tonyy-shin/Smart-Sweat-Band-Project/libraries.md

# Arduino Library Dependencies

All libraries are installed via Arduino IDE Library Manager.

| Library | Author | Version | Purpose | Phase Added |
| :--- | :--- | :--- | :--- | :--- |
| MAX30205 | Protocentral | Latest | Clinical temperature sensor (I2C) | Phase 1 |
