tonyy-shin/Smart-Sweat-Band-Project/hardware/BOM.md

1x Microcontroller Board: ESP32-S3 DevKit
Estimated Cost: $7.49

1x Clinical Temperature Sensor: MAX30205 Breakout Board
Estimated Cost: $21.13

1x Prototyping Wires: 30 AWG Flexible Silicone Stranded Wire
Estimated Cost: $12.99

1x Diagnostic Tool: Micro Test Hook Clips
Estimated Cost: $7.69

1x Data/Sync Cable: USB-C Data Cable
Estimated Cost: $14.99

Estimated Total: $64.29 (without shipping fee)
