tonyy-shin/Smart-Sweat-Band-Project/dev_logs/SSB_devlog_2026-06-30.md

# SSB Dev Log — June 30, 2026

## Summary

Implemented and verified `main.cpp`, the firmware entry point for the Smart
Sweat-Band ESP32S3 device. This completes the Phase 1 firmware integration:
all sensor, storage, and transfer modules (built in milestones 1.0–1.6) are
now wired together into a single working state machine boot sequence. Also
found and fixed a pre-existing, unrelated build-blocking bug in
`platformio.ini`.

No hardware was available today, so all verification was limited to a clean
compile (`pio run`) — physical bench testing is queued for the next session
with the device in hand.

---

## What was implemented

### `firmware/ssb_firmware/src/main.cpp`

Previously an empty file (0 bytes). On inspection, the sensor, storage, and
transfer logic already existed in their own modules (`sensors.cpp`,
`storage.cpp`, `transfer.cpp`, `state_machine.cpp`) — `main.cpp` was the only
missing piece. Implemented as a thin entry point:

- `setup()`: starts Serial at 115200, sets `analogReadResolution(12)`
  (explicit 12-bit ADC documentation), calls `sensors_init()` and
  `state_machine_init()`.
- **Boot-time recovery guard**: if `storage_init() && storage_session_exists()`
  is true, the device jumps straight into `TRANSFER_READY` instead of
  `IDLE`. This prevents a fresh `RECORDING` session from truncating/
  overwriting an unconfirmed prior session still sitting on flash.
- `loop()`: pumps `state_machine_update()` then `led_update()`, with a
  `delay(10)` to keep button/serial polling responsive without busy-spinning.

### Design decisions confirmed during plan review

- **Serial protocol**: kept the existing ASCII scheme already implemented in
  `transfer.cpp` (`'R'` request → CSV stream → `END` sentinel → `'C'`
  confirm), rather than switching to a binary protocol.
- **CSV format**: kept the existing **5-column** row —
  `timestamp_ms, skin_temp_c, humidity_pct, chamber_temp_c, gsr_raw` —
  including the SHT45 chamber temperature column. This is a deliberate
  deviation from the original 4-column spec in `SSB_architecture.md`
  (**architecture doc still needs updating to reflect this** — see Open
  Items below).
- Added an extra verification step beyond the original plan: pulling power
  mid-`RECORDING` (not via Button A) to confirm the boot guard still detects
  a leftover session even when the file was never cleanly closed.

---

## Bug found & fixed: `platformio.ini`

`pio run` failed before compilation ever started — library install aborted
with `UnknownPackageError` on the MAX30205 dependency.

**Root cause**: `lib_deps` had a truncated, miscapitalized package name
(`protocentral/Protocentral MAX30205`) that didn't match the registry.

**Fix**:
```ini
lib_deps =
  adafruit/Adafruit SHT4x Library
  adafruit/Adafruit BusIO
  protocentral/ProtoCentral MAX30205 Body Temperature Sensor Library
```

This was a pre-existing bug unrelated to today's `main.cpp` work — it predates
this session and was simply never triggered until the first `pio run` was
attempted.

---

## Build verification

```
pio run
...
RAM:   6.0% (19,812 / 327,680 bytes)
Flash: 9.8% (327,533 / 3,342,336 bytes)
========================= [SUCCESS] Took 14.32 seconds =========================
```

Clean compile, zero warnings, all module headers/symbols resolved correctly
against `main.cpp`. Plenty of RAM/flash headroom remaining.

---

## Git

Two separate commits (kept apart since the platformio.ini fix is an
unrelated pre-existing bug, not part of the `main.cpp` feature):

1. `fix(firmware): correct ProtoCentral MAX30205 library name in platformio.ini`
2. `feat(firmware): add main.cpp entry point with state machine boot + recovery guard`

---

## Outstanding / next steps

**Requires hardware (queued for next session with the board):**
1. Flash + `pio device monitor` walkthrough of the full state machine:
   `IDLE` → `RECORDING` → `TRANSFER_READY`
2. GSR calibration trigger test (skin contact, 100-sample baseline)
3. Serial transfer test: send `R`, confirm CSV + `END` stream back, send `C`,
   confirm deletion + return to `IDLE`
4. Recovery guard test #1: power-cycle with an *unconfirmed* session in
   `TRANSFER_READY` → confirm reboot lands in `TRANSFER_READY`, not `IDLE`
5. Recovery guard test #2 (new): pull power **mid-`RECORDING`** → confirm
   the guard still catches the leftover (possibly truncated) session on
   reboot
6. Immediate priority once the above pass: physical stress test verifying
   the 20% GSR drop logic fires correctly under real sweat conditions

**Documentation debt:**
- Update `SSB_architecture.md` — the CSV row format section still says
  4 columns; actual implementation uses 5 (includes `chamber_temp_c`).
  `parser.py` (Phase 3) will need to be written against the 5-column format.

**Known non-blocking quirks (existing behavior, flagged not fixed):**
- `sensors_init()` hangs indefinitely if the SHT45 isn't physically present.
- `gsr_calibrate()` blocks during the `IDLE`→`RECORDING` transition until
  skin contact is detected; LED doesn't update during that wait.
- A session recovered via the mid-`RECORDING` power-pull guard may have a
  truncated final CSV row (data since the last 60s flush is lost) —
  `serial_receiver.py` will need to tolerate this when it's built.

---

# Phase 3 Backend — `parser.py` + test/CI foundation (same evening)

## Summary

Started the Python backend the same evening as the `main.cpp` firmware work above.
Implemented `ssb_backend/parser.py`, which converts the firmware's raw session CSV into
structured sample dicts, and stood up the backend's testing/CI foundation: a full `pytest`
suite (9 tests, all passing) plus a GitHub Actions workflow that is now the standing
verification method for backend changes.

Unlike the firmware work above, none of this needs the physical device — the parser is
pure CSV/text processing, so everything here was verified locally and in CI rather than
being queued for hardware bench time.

---

## What was implemented

### `ssb_backend/parser.py` (new, 129 lines)

Public entry point:

```python
def parse_session_csv(csv_data: str | bytes, gsr_baseline: int | None = None) -> ParseResult
```

Parses the firmware's 5-column session CSV
(`timestamp_ms, skin_temp_c, humidity_pct, chamber_temp_c, gsr_raw`) into a `list[dict]`
of samples. **Standard-library only** — `logging`, `re`, `dataclasses`; no external
dependencies.

- **Two-pass line classification.** Pass 1 walks every line and separates *expected
  non-data* lines (blank, `#`-prefixed comment, exact-match header, `END` sentinel) from
  *data-eligible* lines. Pass 2 parses every data-eligible line and accounts for each one.
  The point is that no line can silently vanish — it is either explicitly classified as
  expected non-data, or it is parsed and counted (as a sample or as a failure).
- **Anchored baseline regex.** The firmware's `# gsr_baseline=<int>` comment is matched
  with `^#\s*gsr_baseline\s*=\s*(\d+)`. Anchoring at `^#` prevents a stray
  `gsr_baseline=` elsewhere in a line from being misread. The optional `gsr_baseline`
  parameter takes precedence over the parsed value when supplied (caller override wins).
- **Two distinct failure modes**, reported separately rather than conflated:
  `truncated_final_row: bool` is the expected signature of a power-pull mid-`RECORDING`
  (the last row was mid-write — tolerable), while `malformed_row_count: int` counts any
  *other* row that fails to parse (real mid-session corruption). Downstream code should
  treat these differently, so collapsing them into one count would lose the distinction.

### Testing & CI foundation

- **`ssb_backend/tests/test_parser.py`** — 9 `pytest` functions, all passing:
  `test_wellformed_csv`, `test_truncated_final_row`, `test_malformed_middle_row`,
  `test_baseline_override`, `test_empty_string`, `test_bytes_input`,
  `test_crlf_line_endings`, `test_stray_end_sentinel`, `test_no_baseline_no_override`.
  Covers the happy path, both failure modes, override precedence, empty input, `bytes`
  vs `str` equivalence, CRLF endings, and a stray `END` sentinel.
- **`pyproject.toml`** (repo root) — `pythonpath = ["."]` and
  `testpaths = ["ssb_backend/tests"]` under `[tool.pytest.ini_options]`, resolving the
  `ssb_backend.parser` import from the test file without `sys.path` hacks. Paired with
  package markers `ssb_backend/__init__.py` and `ssb_backend/tests/__init__.py`.
- **`.github/workflows/ci.yml`** — GitHub Actions on `push`/`pull_request`, running the
  suite on Python 3.12 / `ubuntu-latest`. No lint or type-checking yet (deferred). CI is
  now the standing verification method for backend changes.
- **`.gitignore`** — added a `# Python` section (`__pycache__/`, `*.py[cod]`,
  `*.egg-info/`, `.pytest_cache/`) to the existing Arduino/PlatformIO rules. `.venv/` was
  already covered by an earlier entry.

---

## Process notes: bugs caught in pre-commit review

Several draft/review cycles caught bugs before they were committed:

- **Unanchored baseline regex** — an early pattern lacked the `^#` anchor and could have
  matched `gsr_baseline=` text anywhere in a line. Fixed to the anchored form above.
- **Silent-skip heuristic** — an early design skipped non-data-looking lines silently,
  which could have undercounted real data loss. Replaced with the explicit two-pass
  classification so every line is accounted for.
- **Conflated dropped-row counter** — an early `ParseResult` used a single dropped-row
  count that couldn't distinguish tolerable tail truncation from real corruption. Split
  into `truncated_final_row` + `malformed_row_count`.
- **`skin_temps_c` typo** — a hand-typed `_COLUMNS` field was briefly misspelled
  `skin_temps_c` instead of `skin_temp_c`, which would have broken the header exact-match
  check on every real session. Caught and corrected before commit.

---

## Build verification

```
pytest
========================= 9 passed =========================
```

All 9 tests pass locally; CI runs the same suite on Python 3.12 / ubuntu-latest on every
push and PR. No hardware needed.

---

## Git

Two commits, kept scoped separately per this project's convention of not mixing unrelated
concerns (both landed on `main`):

1. `fb43550` — `test(backend): add pytest + GitHub Actions CI`
   (test suite, `ci.yml`, `pyproject.toml`, package `__init__.py` markers, `.gitignore`
   Python section)
2. `740014f` — `feat(backend): add parser.py for CSV parsing`
   (`parser.py` only, 129 lines)

Committed in that order (`fb43550` first, then `740014f`), both timestamped ~16:50.

**Branch convention change going forward:** `parser.py` and its test/CI foundation landed
directly on `main`. From here on, new backend modules (`serial_receiver.py` and beyond)
will be developed on a dedicated `phase3/python-backend` branch rather than committed
straight to `main`.

---

## Outstanding / next steps (backend)

**Next module:**
- `serial_receiver.py` — serial port detection, transfer request (`R`), CSV reception,
  and confirmation send (`C`), per the existing spec in `SSB_architecture.md`. It will
  consume `parse_session_csv()` and must tolerate a `truncated_final_row` from a
  power-pulled session (see the firmware quirks above).

**Testing status:**
- No hardware-dependent testing is needed for backend work so far — parsing and unit
  tests run without the physical device (pure CSV/text processing). The firmware work
  above remains the outstanding hardware item.
