tonyy-shin/Smart-Sweat-Band-Project/dev_logs/SSB_devlog_2026-07-07.md

# SSB Dev Log — July 7, 2026

## Summary

Wired `ssb_backend/algorithm/electrolyte_intensity.py`'s `modifier` and `tier`
into `rehydration.py`, so the rehydration prescription now personalizes its
sodium figure by the GSR-derived relative modifier instead of applying the bare
`SWEAT_SODIUM_MG_PER_L` population constant. This changes sodium's
`calibration_state` from a flat constant to a per-quantity personalized state:
`provisional` when the electrolyte baseline is insufficient, `gsr_adjusted`
once it isn't. Also made a small design simplification in
`electrolyte_intensity.py`'s degenerate-input guard along the way.

As with the rest of Phase 3 backend work, none of this needs the physical
device — everything is exercised via `tmp_path` SQLite files.

---

## Part 1 — Plan review

The wiring went through plan mode before any code was typed. The plan was
reviewed and approved after two rounds of clarification:

- **`modifier=None` vs `1.0` in the degenerate guard.** Confirmed that
  `electrolyte_intensity.py`'s Step 1 guard should hand `rehydration.py` a
  neutral `1.0` rather than `None`, so the consumer never has to special-case a
  missing modifier before multiplying.
- **`Literal` import.** Confirmed `Literal` was already imported in
  `rehydration.py` (used by the existing `status` field), so the two new
  literal-typed fields needed no new import.

---

## Part 2 — Implementation

### `electrolyte_intensity.py` guard change

Step 1's degenerate-input guard (0 samples *or* `gsr_baseline <= 0`) now
returns `modifier=1.0` instead of `None`. This is a design simplification made
independently of the original wiring ask: a neutral `1.0` is what
`rehydration.py` multiplies against with no guarding, so the contract stays
uniform across every return path. It required a corresponding update to
`test_electrolyte_intensity.py` (the guard tests previously asserted
`modifier is None`).

### `rehydration.py` changes

- **Two new `RehydrationResult` fields:** `electrolyte_tier`
  (`Literal["insufficient_data", "low", "typical", "high"]`) and
  `calibration_state` (`dict[str, str]`, tracking `volume` and `sodium`
  independently).
- **`compute_volume_and_sodium` signature:** added a `modifier` parameter; the
  sodium line is now
  `(sweat_volume_ml / 1000.0) * SWEAT_SODIUM_MG_PER_L * modifier`.
- **`compute_rehydration_prescription` signature:** added a `db_path` parameter
  (default `history.DEFAULT_DB_PATH`), threaded through to the electrolyte call
  so tests can isolate history to a `tmp_path` DB.
- **Single `compute_gsr_electrolyte_adjustment` call site:** invoked once after
  the sample guards; `modifier = elec.modifier`, and
  `sodium_state = "provisional" if elec.insufficient_baseline else "gsr_adjusted"`.
  Both the zero-fluid early return and the normal return carry `electrolyte_tier`
  and the `calibration_state` dict.

### Bugs found and fixed during manual implementation

Both were self-caught while typing the implementation, before running the
suite:

1. **Missing fields on the success-path return.** The final
   `return RehydrationResult(...)` (the non-zero-fluid path) was initially
   written without `electrolyte_tier` or `calibration_state`. Since both are
   required dataclass fields, this would have raised `TypeError` on *every*
   real prescription — only the guard/zero-fluid returns would have worked.
2. **`insufficent_data` typo.** A misspelling (missing the second `i`) appeared
   in two places — the `Literal` type annotation on `electrolyte_tier` and the
   early-return string value. Left in, it would have silently disagreed with
   `electrolyte_intensity.py`'s correctly-spelled `"insufficient_data"`,
   breaking equality against the tier the electrolyte module actually emits.

---

## Part 3 — Tests

Changes to `ssb_backend/tests/test_rehydration.py`:

- **4 existing full-equality tests** updated to include the two new fields
  (`test_empty_sample`, `test_single_samples`,
  `test_zero_duration_returns_insufficient_data`,
  `test_zero_fluid_ok_empty_schedule`).
- **10 existing tests** threaded with `tmp_path` / `db_path` so the electrolyte
  call reads an isolated SQLite file instead of the real `ssb_history.db`.
- **1 new test** — `test_sodium_scaled_by_gsr_modifier` — seeds 3 history
  sessions (`gsr_drop_intensity=0.25`) so a current intensity of `0.5` yields a
  raw ratio of `2.0`, hitting `GSR_MODIFIER_MAX_CLAMP`. Asserts
  `calibration_state["sodium"] == "gsr_adjusted"`, `electrolyte_tier == "high"`,
  and that `total_sodium_mg` is exactly doubled.

**Build verification:**
`python -m pytest ssb_backend/tests/test_rehydration.py ssb_backend/tests/test_electrolyte_intensity.py -q`
→ **26 passed.**

---

## Git

Four commits, in dependency order, committed, pushed, and merged into `main`
(PR #11):

1. `fix(backend): default electrolyte modifier to 1.0 in guard`
2. `test(backend): update electrolyte_intensity tests for modifier=1.0`
3. `feat(backend): wire electrolyte_intensity modifier into rehydration`
4. `test(backend): update rehydration tests for electrolyte wiring and DB isolation`

---

## Outstanding / next steps

- **`scoring.py`** is next in dependency order — the composite Recovery
  Readiness Score, and critically the producer of both `thermal_slope` and
  `gsr_drop_intensity`, the two history keys `thermal.py` and
  `electrolyte_intensity.py` currently read via `# CONTRACT:` comments from an
  empty well.
- **Firmware hardware bench verification** and the **GSR 20%-drop real-sweat
  stress test** — still outstanding and hardware-blocked.
- **React/Recharts dashboard** — not started.
- **Vapor chamber ΔRH → mL/min characterization** — partner-led, still gates
  the volume half of `rehydration.py`.

---

# SSB Dev Log — July 7, 2026 (Session 2)

## Summary

Designed and implemented `ssb_backend/algorithm/scoring.py` — the composite
Recovery Readiness Score, and the producer of the `thermal_slope` and
`gsr_drop_intensity` history keys that `thermal.py` and
`electrolyte_intensity.py` have so far read via `# CONTRACT:` comments from
an empty well. That gap, identified in the July 5 audit, is now closed:
full regression proves both readers get non-empty baselines from scoring's
history writes. Also wrote its `pytest` suite (`test_scoring.py`, 11 tests).
Followed the same spec-first process as `electrolyte_intensity.py`: full
design spec reviewed through two critique rounds before any code was typed.

---

## Part 1 — Design spec

Two critique rounds against the spec resolved:

- **`sessions_used` naming collision.** Renamed scoring's field to
  `prior_session_count` — `ThermalResult.sessions_used` and
  `GsrElectrolyteResult.sessions_used` count *filtered valid* entries,
  whereas scoring's field is a raw row count; sharing the name would have
  invited confusion.
- **Explicit per-helper neutral-fallback conditions.**
  `_rehydration_subscore` falls back only when `total_fluid_ml is None`,
  never on a genuine `0.0`; `_thermal_subscore` falls back when *either*
  `current_slope` or `baseline_slope` is `None`; `_sri_subscore` falls back
  when `mean_sri is None`.
- **Field names verified against source.** Every input field was confirmed
  directly against `rehydration.py`/`sweat_rate.py` rather than assumed.
- **Double-compute TODO.** `compute_gsr_electrolyte_adjustment` runs twice
  per pipeline (once inside `rehydration.py`, once for scoring's history
  write) — flagged as an accepted tradeoff for `main.py` to revisit.

### Placeholder constants (with derivations)

- `REHYDRATION_FULL_DEFICIT_ML = 1500.0` — ~5 full 300 mL intake windows,
  a 90-min heavy-session reference deficit.
- `THERMAL_SCORE_GAIN = 5000.0` — calibrated so a slope gap at
  `thermal.py`'s `THERMAL_ALERT_MARGIN_C_PER_S` drops the sub-score 10
  points below neutral, keeping directional agreement with thermal's own
  alert logic.
- `SRI_FULL_STRESS = 0.1` %RH/s — set above the ~0.06–0.08 venting rates
  from the July 4 bench capture, so passive dry-bench readings don't
  misread as full sweat stress.

---

## Part 2 — Side-refactor attempted and reverted

A refactor was tried mid-implementation: adding
`current_intensity: float | None` to `RehydrationResult` so scoring could
read the GSR intensity off it directly instead of taking a fourth
`GsrElectrolyteResult` parameter. It was fully implemented (field + 3
construction sites + 5 `test_rehydration.py` edits) — then a correctness
review of the resulting scoring wiring caught a real bug:
`RehydrationResult.current_intensity` is `None` whenever rehydration's own
<2-sample guard fires, but `electrolyte_intensity.py` needs only 1 sample
to compute a real value. Sourcing scoring's history write from
`RehydrationResult` would silently write `None` in exactly the 1-sample
case where a real value existed — thinning the very baseline
`electrolyte_intensity.py` depends on. Reverted in full; `scoring.py` takes
`gsr_electrolyte_result: GsrElectrolyteResult` as its own fourth parameter
and reads `gsr_drop_intensity = gsr_electrolyte_result.current_intensity`
directly, per the approved spec's §6 recommendation.

---

## Part 3 — Implementation & correctness review

Two review rounds against the approved spec (8 explicit checks: CONTRACT
key correctness, field-source mapping, per-helper fallback conditions,
weighted combination, `prior_session_count` semantics, stabilizing flag,
constant values, score non-nullability). First round found:

1. **Crash bug** — `gsr_drop_intensity` initially sourced from the wrong
   object, raising `AttributeError` on every call (briefly papered over by
   the Part 2 side-refactor rather than fixed at the source).
2. **`stabalizing`/`stabilizing` misspelling** in 3 locations.
3. **Unapplied constant** — `REHYDRATION_FULL_DEFICIT_ML` briefly regressed
   to `1800.0` instead of the derived `1500.0`.
4. **Unbounded sub-score helpers** — `_thermal_subscore`/`_sri_subscore`
   not individually clamped to `[0, 100]`, and `_sri_subscore` used an
   incorrect absolute-cap normalization instead of the proper
   `mean_sri / SRI_FULL_STRESS` scale.

The second round confirmed all fixes landed, including that the crash-bug
fix reads from the restored `gsr_electrolyte_result` parameter (not
`rehydration_result`) after the Part 2 revert.

---

## Part 4 — Tests

`ssb_backend/tests/test_scoring.py` covers the 11 approved cases from the
spec's test plan: weighted-sum correctness, emit-never-withhold under full
insufficiency, CONTRACT key writes, the end-to-end round-trip proving
`thermal.py` and `electrolyte_intensity.py` read non-empty baselines after
3 scoring calls, `None`-thermal-slope handling, the stabilizing-flag
boundary at `SCORE_CALIBRATED_SESSIONS = 5`, directional sanity checks,
clamping at extremes, and `db_path`/timestamp isolation.

**Build verification:**
`test_scoring.py` → **11 passed.** Full regression
(`test_thermal.py` + `test_electrolyte_intensity.py` + `test_scoring.py`)
→ **27 passed** — the CONTRACT keys are not just written correctly but
actually consumable by both readers.

---

## Git

Two commits ready per convention (feature, then test) — **not yet
committed**:

1. `feat(backend): add scoring.py for Recovery Readiness Score`
2. `test(backend): add test_scoring.py for scoring.py`

---

## Outstanding / next steps

- **`api.py`** is next in dependency order (per `SSB_architecture.md`'s
  file structure), followed by **`main.py`** — which should also revisit
  the double-compute TODO from Part 1.
- **Firmware offset fix (`de77b70`)** — still pending cherry-pick onto
  `main` from `fix/hardware-testing`.
- **Firmware hardware bench verification** and the **GSR 20%-drop
  real-sweat stress test** — unchanged, hardware-blocked.
- **React/Recharts dashboard** — not started.
- **Vapor chamber ΔRH → mL/min characterization** — partner-led, still
  gates the volume half of `rehydration.py`.

---

# SSB Dev Log — July 7, 2026 (Session 3)

## Summary

Designed and implemented `ssb_backend/api.py` — the FastAPI surface
exposing `GET /results`, and the full-pipeline orchestrator
(`run_pipeline`) wiring `rehydration.py` → `thermal.py` →
`sweat_rate.py` → `electrolyte_intensity.py` → `scoring.py` →
`history.py`. Also implemented `build_recovery_plan`, a pure
plain-language recovery-plan builder, and wrote its full `pytest` suite
(`test_api.py`, 14 tests). Added `fastapi`, `uvicorn`, and `httpx` to
`requirements.txt`. Followed the same spec-first process as
`electrolyte_intensity.py` and `scoring.py`: full design spec reviewed
through two critique rounds before any code was typed.

---

## Part 1 — Design spec

Two critique rounds against the spec resolved:

- **Single-history-write invariant.** `scoring.py` already writes the
  session to history; `api.py` must *not* call `save_session` again.
  `run_pipeline` therefore performs no history write of its own.
- **Double-compute deferral accepted.**
  `compute_gsr_electrolyte_adjustment` runs twice per pipeline — once
  inside `rehydration.py`, once for scoring's 4th parameter. This is
  the same accepted tradeoff flagged in Session 2, deliberately
  deferred to `main.py` and not resolved here.
- **Emit-and-label fix in the thermal clause.** `build_recovery_plan`'s
  thermal clause now appends "(baseline still stabilizing)" when
  `insufficient_baseline` is `True`, emitting the message rather than
  withholding it.
- **404 vs `has_session: false`.** Explicit tradeoff decision on what
  `GET /results` returns before any pipeline run: chose **404**.

---

## Part 2 — Implementation

`ssb_backend/api.py` contains:

- **`GET /results`** — the FastAPI endpoint serving the latest pipeline
  results, returning 404 when no session has been processed yet.
- **`run_pipeline`** — the full-pipeline orchestrator, calling
  `rehydration.py` → `thermal.py` → `sweat_rate.py` →
  `electrolyte_intensity.py` → `scoring.py` → `history.py` in
  dependency order (history writes happen inside `scoring.py`, per the
  single-write invariant above).
- **`build_recovery_plan`** — a pure function translating pipeline
  results into a plain-language recovery plan.

`requirements.txt` gained `fastapi`, `uvicorn`, and `httpx`.

---

## Part 3 — Tests

`ssb_backend/tests/test_api.py` covers 14 cases, following the
`tmp_path` SQLite isolation convention used across the backend suites.
Notable: the **strengthened double-compute consistency check** —
asserting that the two `compute_gsr_electrolyte_adjustment` runs agree
not just on tier match but on *exact numeric equality* of
`total_sodium_mg`.

---

## Git

Three commits, in dependency order (feature → test → build, per
convention), committed, pushed, and merged into `main` (PR #13):

1. `feat(backend): add api.py for FastAPI results endpoint and pipeline orchestration`
2. `test(backend): add test_api.py for api.py`
3. `build: add fastapi, uvicorn, and httpx to requirements.txt for api.py`

---

## Outstanding / next steps

- **`main.py`** is next in dependency order — wires the serial listener
  to `run_pipeline`, and should revisit the double-compute deferral
  from Part 1.
- **Firmware offset fix (`de77b70`)** — still pending cherry-pick onto
  `main` from `fix/hardware-testing`.
- **Firmware hardware bench verification** and the **GSR 20%-drop
  real-sweat stress test** — unchanged, hardware-blocked.
- **React/Recharts dashboard** — not started.
- **Vapor chamber ΔRH → mL/min characterization** — partner-led, still
  gates the volume half of `rehydration.py`.
