tonyy-shin/Smart-Sweat-Band-Project/firmware/hardware_validation/phase1.0_baseline_thermometry/i2c_scanner/i2c_scanner.ino

#include <Wire.h>

void setup() {
  Serial.begin(115200);
  Wire.begin(D4, D5);
  Serial.println("Scanning I2C bus...");

  for (byte address = 1; address < 127; address++) {
    Wire.beginTransmission(address);
    byte error = Wire.endTransmission();

    if (error == 0) {
      Serial.print("Device found at address 0x");
      if (address < 16) Serial.print("0");
      Serial.println(address, HEX);
    }
  }
  Serial.println("Scan complete.");
}

void loop() {}
