tonyy-shin/Smart-Sweat-Band-Project/(commit log)

2026-03-18 Create BOM.md
    Added hardware bill of materials.
2026-04-12 feat: scaffold project structure for Phase 1
    - Add firmware/phase1_thermometry/ for Arduino sketch files
    - Add hardware/photos/ for build documentation images
    - Add docs/wiring/ for schematics and wiring diagrams
    - Add libraries.md to track Arduino library dependencies
2026-04-16 feat: add I2C scanner sketch and Phase 1 hardware photo
2026-04-16 feat: add phase 1 temperature reading sketch which includes calibration
2026-05-22 Add standalone SHT45 firmware and unified dual-sensor code
    Added a dedicated script to run and test the SHT45 humidity sensor independently. Also added a combined script to run both the SHT45 and the custom MAX30205 clone simultaneously on the shared I2C bus.
2026-05-22 Add dual-sensor breadboard wiring photo to hardware folder
2026-05-26 feat:sensor fusion with GSR calibration
2026-05-26 docs: sensor fusion setup
2026-06-29 fix: transition from windows to linux
    [i2c_scanner.ino, phase.1.5_sensor_fusion.ino, phase1.1_temp_read.ino, phase1.2_humidity_read.ino, phase1.3_temp_humidity_read.ino, phase1.4_gsr_read.ino]
2026-06-29 feat: Add ssb_firmware scaffold and sensors module
2026-06-29 fix: added storage delete method
    [storage.cpp, storage.h]
2026-06-29 feat: Add state machine module (4-state FSM, buttons, LED, 1Hz sampling)
2026-06-30 feat(firmware): implement USB Serial transfer handshake module (transfer.h/.cpp) and wire it into the state machine.
2026-06-30 fix: csv output spacing error
    [storage.cpp]
2026-06-30 refactor(firmware): added calibrated GSR to output
2026-07-01 feat(backend): add serial_receiver.py for USB device detection and transfer
2026-07-06 fix(backend): tolerate space-flexible gsr_baseline prefix in _looks_like_ssb
    [serial_receiver.py]
2026-07-07 feat(backend): wire electrolyte_intensity modifier into rehydration
2026-07-07 test(backend): update rehydration tests for electrolyte wiring and DB isolation
2026-07-08 feat(backend): wire _run_algorithm_pipeline to call run_pipeline
2026-07-08 fix(backend): pass computed elec into rehydration to eliminate double-compute
    [api.py]
2026-07-08 feat(backend): add GET /results/samples endpoint for raw sample time series
2026-07-08 test(backend): add tests for GET /results/samples endpoint
2026-07-08 feat(frontend): wire SessionHistoryPanel to /history with per-metric trend charts
2026-10-02 fix(firmware): clear stale button presses and serial input across state transitions
    [state_machine.cpp, transfer.cpp]
2026-10-14 Docs: plan wearable stage of project
